jmartens90/IoT_SynthPatch/hardware/mouser_bom_iot_synthpatch.csv

Manufacturer Part Number | Manufacturer | Order Qty | Qty needed | Description | Designators (M=main, A=analog)
PEC16-4115F-S0012 | Bourns | 1 | 1 | Rotary encoder w/ switch | M:ENC1
SRN6045TA-6R8M | Bourns | 2 | 2 | 6.8uH power inductor 6x6 | M:L1 M:L2
HCPL-0700-000E | Broadcom | 1 | 1 | Optocoupler SO-8 | M:Q9
7101SD9CQE | C&K | 1 | 1 | SPDT toggle switch | M:SW3
OS102011MA1QN1 | C&K | 2 | 2 | SPDT slide switch (check pitch vs SS-12D00) | M:SW1 M:SW2
DFR0664 | DFRobot | 1 | 1 | 2.0in IPS TFT display | M:J18
1N4148WS-7-F | Diodes Inc | 11 | 11 | Switching diode SOD-323 | A:D3 A:D4 A:D5 A:D6 A:D7 A:D8 A:D9 A:D10 M:D11 M:D14 M:D15
AP2112K-3.3TRG1 | Diodes Inc | 1 | 1 | 3.3V LDO SOT-23-5 | M:U1
B340A-13-F | Diodes Inc | 4 | 2 | 3A Schottky SMA | M:D1 M:D2
MMBT3904-7-F | Diodes Inc | 18 | 16 | NPN SOT-23 | A:Q1 A:Q2 A:Q3 A:Q4 A:Q5 A:Q6 A:Q7 A:Q8 M:Q10 M:Q11 M:Q12 M:Q13 M:Q14 M:Q15 M:Q16 M:Q17
ESP32-S3-WROOM-1-N16R2 | Espressif | 1 | 1 | ESP32-S3 module | M:IC2
SM04B-SRSS-TB(LF)(SN) | JST | 1 | 1 | JST-SH 4-pin (STEMMA QT/Qwiic) | M:J21
C0805C101J5GACTU | KEMET | 11 | 10 | 100pF 50V C0G 0805 | A:C32 A:C33 A:C35 A:C36 A:C52 A:C53 A:C54 A:C55 A:C56 A:C57
C0805C102J5GACTU | KEMET | 10 | 2 | 1nF 50V C0G 0805 | M:C12 M:C25
C0805C103K5RACTU | KEMET | 10 | 7 | 10nF 50V X7R 0805 | M:C9 M:C16 M:C21 M:C27 M:C64 M:C66 M:C92
C0805C104K5RACTU | KEMET | 33 | 30 | 100nF 50V X7R 0805 | A:C30 A:C31 A:C34 A:C45 A:C46 A:C49 A:C50 A:C60 A:C67 A:C70 A:C73 A:C74 A:C76 A:C87 M:C1 M:C6 M:C15 M:C17 M:C18 M:C28 M:C38 M:C39 M:C42 M:C43 M:C63 M:C65 M:C84 M:C86 M:C88 M:C40
C0805C105K5RACTU | KEMET | 10 | 6 | 1uF 50V X7R 0805 | A:C69 A:C72 M:C2 M:C4 M:C14 M:C90
C0805C106K3PACTU | KEMET | 20 | 18 | 10uF 25V X5R 0805 | A:C44 A:C47 A:C48 A:C51 A:C58 A:C59 A:C68 A:C71 A:C75 A:C77 M:C3 M:C5 M:C29 M:C37 M:C41 M:C61 M:C62 M:C89
C0805C154K5RACTU | KEMET | 10 | 1 | 150nF 50V X7R 0805 | M:C82
C0805C271J5GACTU | KEMET | 10 | 2 | 270pF 50V C0G 0805 | A:C78 A:C79
C0805C470J5GACTU | KEMET | 10 | 2 | 47pF 50V C0G 0805 | M:C13 M:C26
C0805C475K3PACTU | KEMET | 10 | 5 | 4.7uF 25V X5R 0805 | M:C7 M:C8 M:C19 M:C20 M:C91
C0805C680J5GACTU | KEMET | 10 | 2 | 68pF 50V C0G 0805 | A:C80 A:C81
LTST-C171GKT | Lite-On | 5 | 3 | Green LED 0805 | M:DS1 M:DS2 M:DS3
SSL-LX4673GD-LA20 | Lumex | 18 | 16 | Green rect. TH LED | M:DS4 M:DS5 M:DS6 M:DS7 M:DS8 M:DS9 M:DS10 M:DS11 M:DS12 M:DS13 M:DS14 M:DS15 M:DS16 M:DS17 M:DS18 M:DS19
216990-0002 | Molex | 1 | 1 | USB-C receptacle | M:J1
BLM21PG600SN1D | Murata | 4 | 2 | Ferrite bead 60R 0805 | M:FB1 M:FB2
GRM32ER61A476KE20L | Murata | 7 | 5 | 47uF 10V X5R 1210 | M:C10 M:C11 M:C22 M:C23 M:C24
74HC165D,653 | Nexperia | 3 | 3 | Shift register SO-16 | A:IC6 A:IC13 A:IC17
EEE-1EA100SR | Panasonic | 3 | 2 | 10uF 25V alu SMD 4x5.4 (replaces 47uF, see note) | M:C83 M:C85
PPPC141LFBN-RC | Sullins | 1 | 1 | 1x14 female header 8.5mm | M:H3
PPPC202LFBN-RC | Sullins | 2 | 2 | 2x20 female header 8.5mm | M:H1 M:H2
PREC002SAAN-RC | Sullins | 2 | 2 | 1x2 male header | M:J19 M:J24
PREC003SAAN-RC | Sullins | 4 | 4 | 1x3 male header | A:J25 A:J27 A:J29 A:J30
PREC014SAAN-RC | Sullins | 1 | 1 | 1x14 male header | A:H3
PREC020DAAN-RC | Sullins | 2 | 2 | 2x20 male header | A:H1 A:H2
1825910-6 | TE Connectivity | 9 | 8 | 6x6 tactile switch | M:SW4 M:SW5 M:SW6 M:SW7 M:SW8 M:SW9 M:SW10 M:SW11
DAC124S085CIMM/NOPB | Texas Instruments | 2 | 2 | Quad 12-bit DAC | M:IC7 M:IC11
DAC8562SDGSR | Texas Instruments | 1 | 1 | Dual 16-bit DAC | M:IC4
LM4040CEM3-5.0/NOPB | Texas Instruments | 1 | 1 | 5V shunt reference SOT-23 | M:IC14
LP2985-50DBVR | Texas Instruments | 1 | 1 | 5V LDO SOT-23-5 | M:U2
PCM1808PWR | Texas Instruments | 1 | 1 | Audio ADC TSSOP-14 | A:IC15
SN74HCT125DR | Texas Instruments | 1 | 1 | Quad buffer SO-14 | M:IC10
TL072ACDR | Texas Instruments | 1 | 1 | Dual op-amp SO-8 | A:IC16
TL074CDR | Texas Instruments | 3 | 3 | Quad op-amp SO-14 | A:IC5 A:IC8 A:IC9
TLC5916IDR | Texas Instruments | 1 | 1 | 8-ch LED driver SO-16 | A:IC12
TPS54331DR | Texas Instruments | 2 | 2 | 3A buck SO-8 | M:IC1 M:IC3
BAT54S-E3-08 | Vishay | 4 | 2 | Dual Schottky SOT-23 | A:D12 A:D13
61201021621 | Wurth Elektronik | 1 | 1 | 2x5 shrouded header 2.54 | M:J31
RC0805FR-07100KL | Yageo | 31 | 28 | 100K 1% 0805 | A:R30 A:R31 A:R42 A:R43 A:R46 A:R47 A:R50 A:R51 A:R96 A:R97 A:R102 A:R103 A:R108 A:R109 A:R114 A:R115 A:R125 A:R126 A:R129 A:R130 M:R94 M:R95 M:R100 M:R101 M:R106 M:R107 M:R112 M:R113
RC0805FR-0710K2L | Yageo | 10 | 2 | 10.2K 1% 0805 | M:R3 M:R15
RC0805FR-0710KL | Yageo | 47 | 42 | 10K 1% 0805 | A:R1 A:R28 A:R29 A:R32 A:R33 A:R34 A:R35 A:R36 A:R37 A:R38 A:R39 A:R40 A:R41 A:R44 A:R45 A:R48 A:R49 A:R81 A:R82 A:R83 A:R84 A:R85 A:R86 A:R87 A:R88 A:R132 A:R133 A:R134 A:R135 A:R136 A:R137 A:R138 A:R139 M:R7 M:R19 M:R76 M:R117 M:R118 M:R119 M:R120 M:R121 M:R122
RC0805FR-0710RL | Yageo | 10 | 1 | 10R 1% 0805 | A:R123
RC0805FR-071K96L | Yageo | 10 | 1 | 1.96K 1% 0805 | M:R17
RC0805FR-071KL | Yageo | 13 | 11 | 1K 1% 0805 | M:R91 A:R26 A:R27 A:R55 A:R57 A:R61 A:R63 A:R67 A:R69 A:R73 A:R75
RC0805FR-0720KL | Yageo | 25 | 22 | 20K 1% 0805 | A:R20 A:R21 A:R22 A:R23 A:R24 A:R25 A:R52 A:R53 A:R54 A:R56 A:R58 A:R59 A:R60 A:R62 A:R64 A:R65 A:R66 A:R68 A:R70 A:R71 A:R72 A:R74
RC0805FR-07220RL | Yageo | 10 | 1 | 220 1% 0805 | M:R90
RC0805FR-0722RL | Yageo | 10 | 2 | 22 1% 0805 | M:R77 M:R78
RC0805FR-07270RL | Yageo | 10 | 1 | 270 1% 0805 | M:R89
RC0805FR-0727KL | Yageo | 10 | 2 | 27K 1% 0805 | A:R124 A:R128
RC0805FR-0729K4L | Yageo | 10 | 2 | 29.4K 1% 0805 | M:R13 M:R79
RC0805FR-072KL | Yageo | 10 | 1 | 2K 1% 0805 | A:R80
RC0805FR-07300RL | Yageo | 10 | 8 | 300 1% 0805 | M:R92 M:R93 M:R98 M:R99 M:R104 M:R105 M:R110 M:R111
RC0805FR-07332KL | Yageo | 10 | 2 | 332K 1% 0805 | M:R2 M:R14
RC0805FR-0733RL | Yageo | 10 | 3 | 33 1% 0805 | M:R1 M:R20 M:R21
RC0805FR-073K24L | Yageo | 10 | 1 | 3.24K 1% 0805 | M:R5
RC0805FR-073K3L | Yageo | 10 | 1 | 3.3K 1% 0805 | M:R116
RC0805FR-07470RL | Yageo | 10 | 2 | 470 1% 0805 | A:R127 A:R131
RC0805FR-075K1L | Yageo | 10 | 5 | 5.1K 1% 0805 | M:R8 M:R9 M:R10 M:R11 M:R12
RC0805FR-0768K1L | Yageo | 10 | 2 | 68.1K 1% 0805 | M:R6 M:R18
RC0805JR-070RL | Yageo | 10 | 2 | 0 1% 0805 | M:R4 M:R16
QPC02SXGN-RC | Sullins | 6 | 6 | 2.54mm jumper shunt for J19 J24 J25 J27 J29 J30
