jmartens90/IoT_SynthPatch/3D/DFR0664.STEP

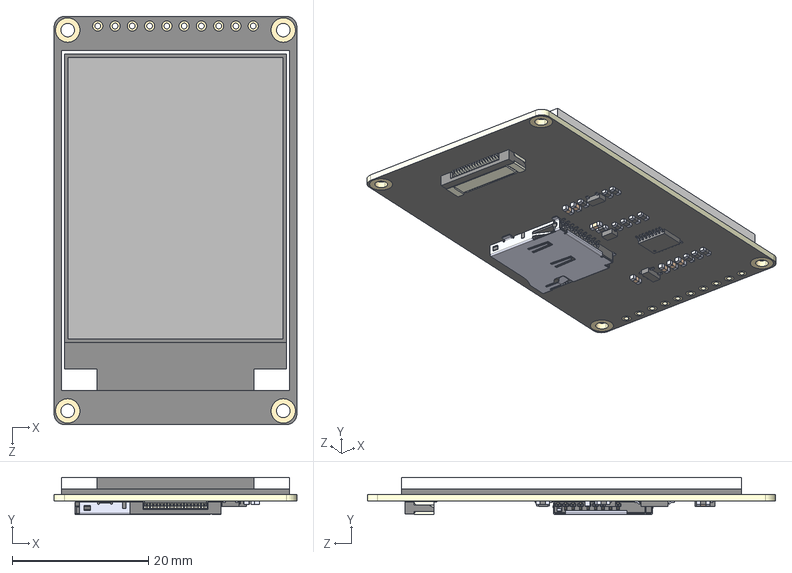
[picture p2: CAD file, 2026-10-27]
3D/DFR0664.STEP
35.7 x 5.50 x 60.0 mm
DFR0664 board
DFR0664 card reader
DFR0654 display interface
res^DFR0664
screen^DFR0664
