jmartens90/IoT_SynthPatch/(list of files, drawings)

Other design files:
ADC.SchDoc
hardware/ADC.SchDoc
hardware/ANALOG/ADC_A.SchDoc
hardware/ANALOG/ADC_AMPS.SchDoc
hardware/ANALOG/CONNECTORS.SchDoc
hardware/ANALOG/INPUTS_GATES_A.SchDoc
hardware/ANALOG/IoT_SYNTHPATCH_ANALOG.PcbDoc
hardware/ANALOG/IoT_SYNTHPATCH_ANALOG.PrjPcb
hardware/ANALOG/LFO_AMPS.SchDoc
hardware/ANALOG/MENU_BUTTONS_A.SchDoc
hardware/ANALOG/MUTE_BUTTONS_A.SchDoc
hardware/ANALOG/VOCT_AMPS.SchDoc
hardware/CONNECTORS.SchDoc
hardware/DAC_LFO.SchDoc
hardware/DAC_VOCT.SchDoc
hardware/DISPLAY.SchDoc
hardware/INPUTS_GATES.SchDoc
hardware/IoT_SYNTHPATCH.PcbDoc
hardware/IoT_SYNTHPATCH.PcbLib
hardware/IoT_SYNTHPATCH.PrjPcb
hardware/IoT_SYNTHPATCH.SchLib
hardware/Main.SchDoc
hardware/MENU_BUTTONS.SchDoc
hardware/MIDI.SchDoc
hardware/MUTE_BUTTONS.SchDoc
hardware/POWER.SchDoc
IoT_SYNTHPATCH.PcbDoc
IoT_SYNTHPATCH.PcbLib
IoT_SYNTHPATCH.PrjPcb
Main.SchDoc
MENU_BUTTONS.SchDoc
MIDI.SchDoc
POWER.SchDoc
