jmartens90/IoT_SynthPatch/(commit log)

2026-10-27 Full schematic + start PCB. Front component placed. Back USB + Critical IC's placed
2026-11-02 PCB V1 Hardware: schematics, PCB's, libraries, gerbers --- PCB's + Components ordered
2026-11-02 Add bring-up test plan, IoT project plan and bring-up firmware
    - docs/bringup-test-plan.md: staged power-on and test procedure (stages 0-11)
    with pass criteria, power jumper table and results log
    - docs/iot-project-plan.md: course rubric mapping, block diagram, technology
    choices, nice-to-have selection, firmware roadmap, MQTT topics, demo shot list
    - firmware/bringup: PlatformIO serial test shell for every subsystem
    (CV/V-oct DACs with calibration, TLC5916, 74HC165 chain, encoder, MIDI,
    SHT45, PCM1808 I2S analysis, ST7789 display + SD, WiFi/HTTP smoke test)
    - GitHub Actions workflow that builds the firmware
    - Root README and firmware README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
2026-11-02 Plan: reduce scope to temperature + voltage graph, LFO/envelope from web and TFT
    Claude-Session: https://claude.ai/code/session_01Gu3mhMgFB9Um4VNt5r7ZtB
2026-11-02 Plan: oscillator frequency via PCM1808 and note-vs-drift detection; bring-up adc shows note + cents
    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
2026-11-02 App firmware stage A1: modulation engine in plain C++17 with PC demo and tests
    Lfo/Envelope on an abstract Modulator, Waveform strategy, Param encapsulation,
    Command queue, Signal observer, factory, CvOutput adapter interface. Every file
    explains the C++ concept it shows. CMake project opens in Qt Creator; 27 checks
    pass with g++. Plan switched to a Qt app (desktop + Android).
    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
2026-11-02 Bring-up: breadboard dev kit env + wiring guide, internal encoder pull-ups
    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
2026-11-05 Prototype firmware for a bare ESP32-S3 dev kit while PCB parts are delayed
    - firmware/prototype: MCP4725 (LFO, optional 2nd for envelope or PWM fallback) and
    AD5693R (16-bit V/oct with 2-point calibration in NVS) as CvOutput adapters,
    auto-detected temperature sensor (SHT45 / DS18B20 / internal), GPIO frequency
    counter instead of the PCM1808, web GUI with live chart, LFO/envelope controls and
    keyboard, REST API, CSV log, MQTT telemetry/events/settings/commands with last will,
    AP fallback. Wiring guide in WIRING.md.
    - engine: PitchTracker (note vs drift classifier) with PC tests (39 checks pass).
    Claude-Session: https://claude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
2026-11-05 Backend: Mosquitto + Python MQTT logger into SQLite + history page, docker compose
    Stores telemetry, note events, settings and online/offline (last will) per device, serves
    a REST API and a history chart, and forwards commands to the module over MQTT.
    Tested with a local broker and a fake ESP client.
    Claude-Session: https://claude.ai/code/session_01Gu3mhMDLvQ3HLjwfjcKS26
2026-11-05 Backend: Raspberry Pi install steps and systemd service
    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
2026-11-05 Prototype: DHT11 temperature fallback on GPIO 16, N16R8 note in wiring
    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
2026-11-05 Rename engine Signal.h to SignalSlot.h: on Windows it shadowed <signal.h>
    Windows file names are case-insensitive, so the ESP32 toolchain's #include <signal.h>
    found the engine's Signal.h through lib_extra_dirs and failed with 'template with C linkage'.
    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
2026-11-05 Prototype: fix envelope PWM setup (11-bit), no NVS NOT_FOUND on first boot, wait for USB serial
    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
2026-11-05 Prototype: no NVS error logs for unset WiFi/MQTT keys
    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
2026-11-05 Prototype: serial shell on the UART port (CDC on boot off)
    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
2026-11-05 Prototype: AD5693R soft reset at start, report I2C ACK and code in the voct/note commands
    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
2026-11-05 Prototype: voct gain 1|2 shell command to check the AD5693R gain bit
    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
2026-11-05 Prototype: AD5693R gain 1 (0-2.5 V) by default, the Adafruit board runs the chip on 3.3 V
    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
2026-11-05 Prototype: back to AD5693R gain 2 without the soft reset (it left the chip at gain 1), clamp at 3.3 V
    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
2026-11-06 Prototype: store 46 days of measurements in the ESP32's own flash
    - 16 MB partition table: 2x 4 MB app slots + 7.9 MB LittleFS, PSRAM on
    - DataLog: ring-buffer file of 16-byte records every 10 s, binary search by time,
    block reads, averaging for charts
    - NTP time (CET/CEST) in station mode; logging only with a valid clock
    - REST: /api/log?hours=&points= and chunked /log-full.csv?days=
    - Web page: range picker (live, 1 h, 24 h, 7 d, 14 d, 46 d), humidity series
    - Shell: log, log clear
    - README: on-device storage, REST API table, flash layout
    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
2026-11-06 Prototype web page: synth panel with knobs and named patch memory
    - LFO limited to what the 0..3.3 V DAC can do: depth 0..1.65 V around a
    1.65 V centre, offset 0..3.3 V (shown as +-1.65 V); envelope peak 0..3.3 V
    - Param/Modulator::setRange in the engine (+4 PC tests)
    - Knob UI (SVG), LFO scope that marks clipping, ADSR graph, shape buttons
    - PatchBank: 4 banks x 8 named patches as JSON files in LittleFS, loaded
    through the engine command queue; REST /api/patches, /api/patch/{save,load,delete}
    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
2026-11-06 Prototype: 16-step sequencer with retrig/legato modes, gate out and trigger in
    - engine: Sequencer (16 steps, 20-300 BPM, retrig = gate per step, legato = one
    gate per loop, trigger() restarts at step 1), ticked in the 1 kHz engine task;
    5 PC tests
    - gate output GPIO 4 (follows every envelope gate), trigger input GPIO 5
    (rising edge restarts the sequencer); BOOT button restarts while running
    - REST /api/seq (GET/POST JSON), /api/seq/run, /api/seq/trig, /api/seq/pos;
    shell `seq start|stop|trig`; the sequence is saved in patches
    - web page: sequencer panel with transport, mode, BPM/GATE/STEPS knobs, step
    grid with running light, keyboard step entry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
2026-11-07 Sequencer: transpose from the key played, steady running light
    - Sequencer::trigger(note): restart at step 1 transposed relative to C3 (the
    keyboard's bottom C); status() for the page; 2 more PC tests (50 total)
    - keys: with a step selected = step entry, otherwise restart transposed
    - running light animated in the browser from the ESP's step/phase/step time
    (polling alone skipped steps); /api/seq/pos returns len, so the light can't
    run into the greyed steps; re-sync right after play/stop/trig
    - shell `seq` prints the steps, transpose and V/oct; monitor shows the V/oct note
    Claude-Session: https://claude.ai/code/session_01Gu3mhMDL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
2026-11-07 Prototype: push live values and sequencer position over a WebSocket
    - WebSocket server on port 81 (links2004/WebSockets): live values every
    second, sequencer position on every start/stop/restart/tempo change and
    every 5 s against drift; sent from loop() only (library not thread-safe)
    - Sequencer::Status::epoch tells the web side when to push
    - page: no more polling of /api/live or /api/seq/pos; reconnects every 2 s;
    REST endpoints stay for commands and other clients
    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
2026-11-07 Prototype: guard the frequency input against interrupt storms, drop PSRAM flag
    - GPIO 13 gets a pull-down (a floating pin can fire the edge interrupt
    hundreds of thousands of times a second)
    - more than 20 kHz of edges = noise: the interrupt pauses for 1 s
    - no -DBOARD_HAS_PSRAM: unused, and the kit reported "PSRAM ID read error"
    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
2026-11-07 Prototype: note the N16R8 test kit (octal PSRAM, GPIO 35-37 reserved)
    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
2026-11-07 Prototype: outputs view with CV scope and V/oct note log
    - App::outputNote: every V/oct note (sequencer, web keys, shell) goes through
    one function and is logged (time, note, volts, DAC code, source)
    - WebSocket pushes the three DAC outputs every 20 ms in packs of 10 ("cv")
    and new V/oct notes ("notes"); a new page gets the last 32 notes
    - page: OUTPUTS panel with a 10 s three-lane scope and the note log
    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
2026-11-07 Prototype page: piano-roll sequencer and note blocks in the outputs view
    - sequencer steps are edited in a piano roll: click to draw a note block,
    drag to change pitch, click a block to delete it; block width = gate length,
    legato blocks join; playhead highlights the column; step numbers select a
    step for keyboard entry
    - outputs view: V/oct lane drawn as note blocks (while the envelope is open)
    with half the scope height
    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
2026-11-07 Prototype: flash log also works in access-point mode (clock from the browser)
    - POST /api/time?t=<unix>: sets the ESP clock when NTP hasn't (AP mode has no
    internet); NTP always wins
    - the page sends its clock once when the ESP reports time 0
    - time zone also set in AP mode, so the CSV shows local time
    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
2026-11-07 Prototype: one Api for HTTP and Bluetooth, BLE link for the Android app
    - Api (Api.h/.cpp): every /api command and all pushes (live, seq, cv, notes)
    in one place, independent of the transport; WebUi now only does WiFi, the
    page, the WebSocket and the CSV downloads
    - BleLink: NimBLE GATT service (RX write / TX notify), JSON lines, requests
    {"id","m","p","b"} answered with {"type":"reply",...}, same pushes as the
    WebSocket, chunked to the MTU and paced
    - WiFi and BLE run at the same time
    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
2026-11-07 Split web page and app into tabs: Synth, Seq, Patches, Outputs, Monitor
    The web page showed every panel on one long page; it now has the same
    five tabs as the app (tab kept in the URL hash, canvases redraw on switch).
    The app's Monitor page is split: the CV scope and note log move to an
    Outputs tab.
    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
2026-11-07 BPM counts steps (one step per beat); app pages fit the screen without scrolling
    - Sequencer: one step = 60/bpm s (was a 16th note, 4x faster than shown).
    Tests updated, 50 pass.
    - App: no ScrollView any more. Canvases take the spare height, the piano
    roll rows share the space left above the keyboard, transport and mode
    buttons are one row, the note log shows what fits.
    - Status says 'Bluetooth: connected', the Monitor shows the ESP's own WiFi
    as 'ESP on WiFi'.
    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
2026-11-07 app: piano roll shows 8 steps x 1 octave at a time (bigger cells)
    1-8 / 9-16 buttons (when STEPS > 8) and octave up/down pick the window;
    notes outside the octave show as an arrow with their name. The first
    octave is chosen from the pattern's notes.
    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
2026-11-07 app: plain-text button labels (Android font has no arrow/play glyphs), compact seq buttons, show ms/step
    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
2026-11-08 Docs for the interim evaluation: problem statement without MQTT/DB, current test setup, wiring diagram, PCB plan
    Claude-Session: https://claude.ai/code/session_01Gu3mhMRjJrxi4omfpMDvps
